gregclacker/Embed2-chicken-coop/kicad/stm test.kicad_pcb

## KiCad design kicad/stm test.kicad_pcb (2026-04-02)

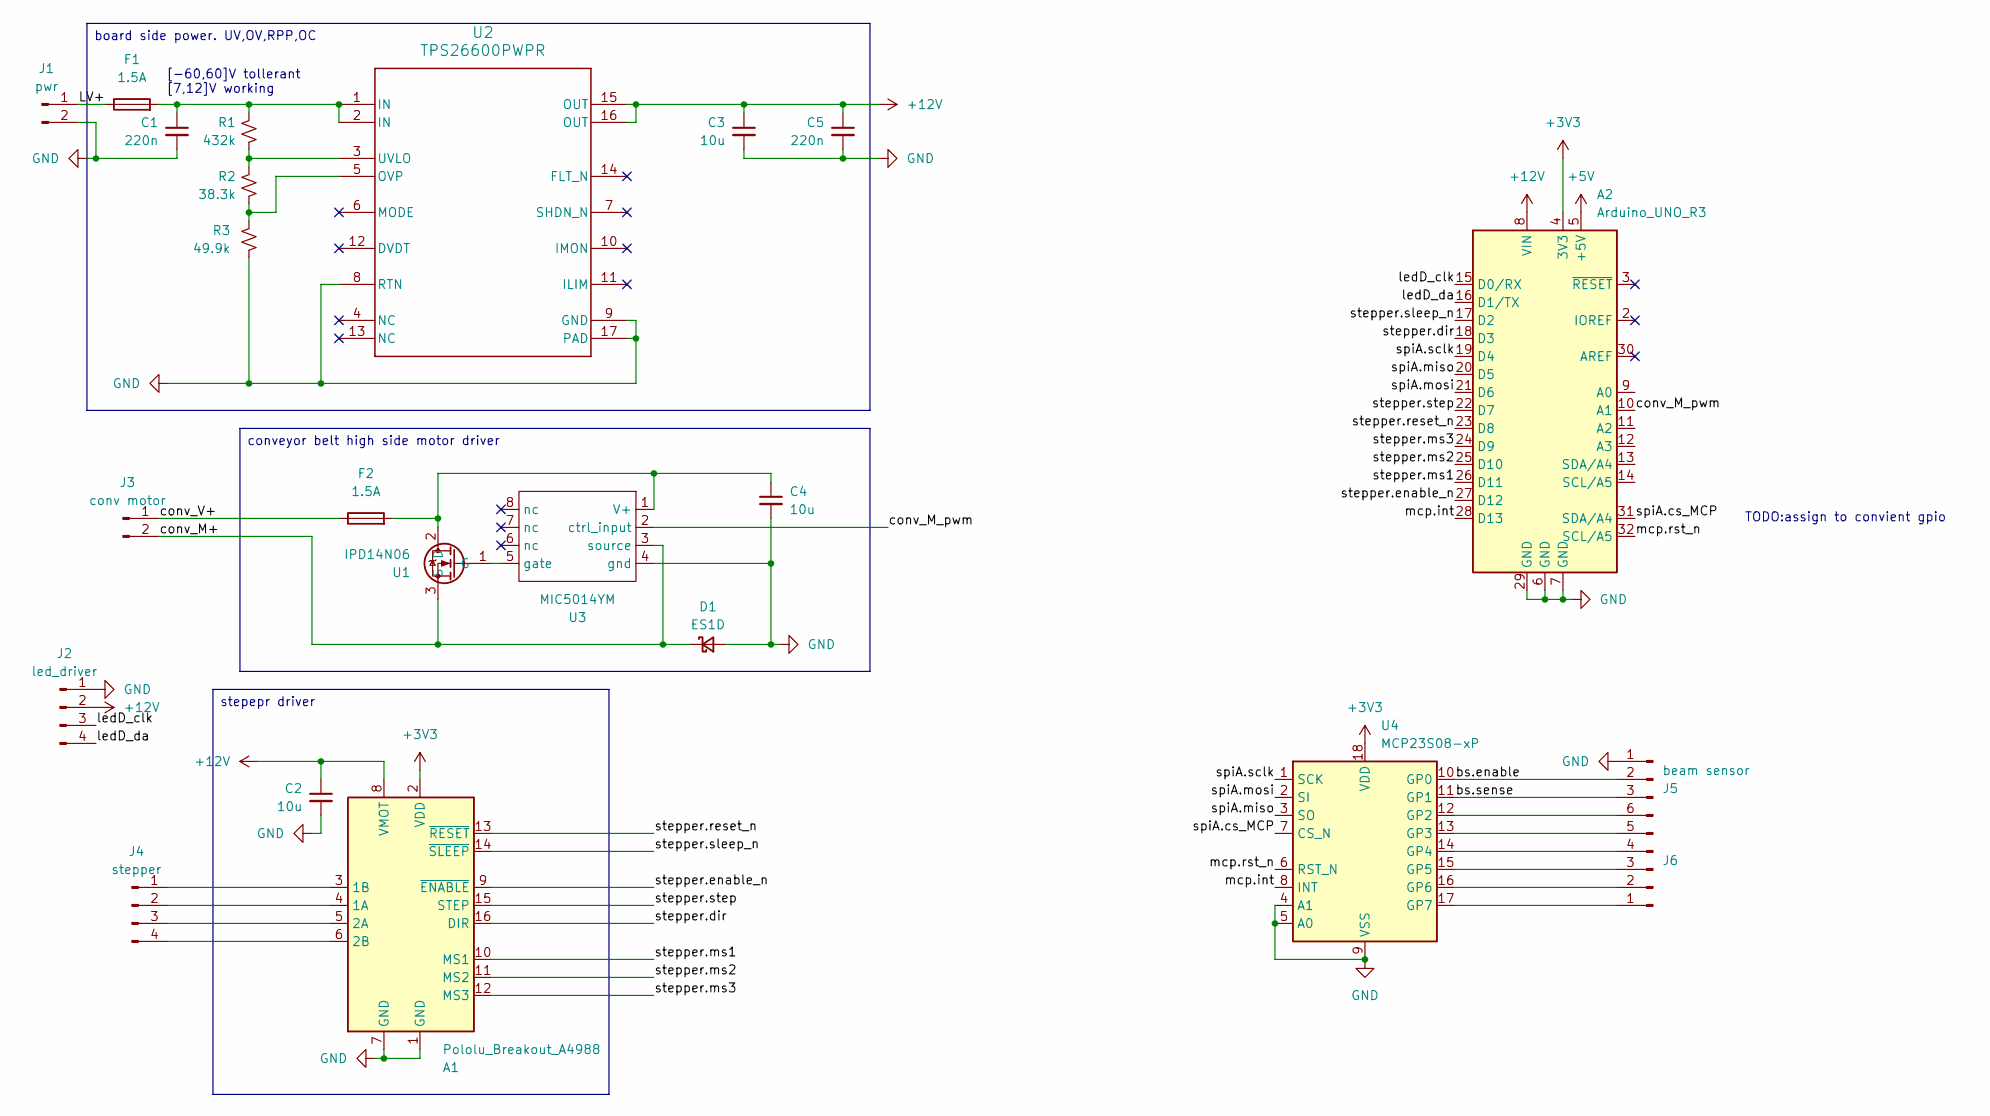
[picture p1: schematic stm test.kicad_sch]

Parts:
A1: Pololu_Breakout_A4988; Pololu_Breakout-16_15.2x20.3mm
A2: Arduino_UNO_R3
C1, C5: 220n; C_0805_2012Metric_Pad1.18x1.45mm_HandSolder
C2, C3, C4: 10u; C_1206_3216Metric_Pad1.33x1.80mm_HandSolder
D1: ES1D; D_SMA
F1, F2: 1.5A; R_Axial_DIN0207_L6.3mm_D2.5mm_P7.62mm_Horizontal
J1: pwr; TerminalBlock_Xinya_XY308-2.54-2P_1x02_P2.54mm_Horizontal
J2: led_driver; TerminalBlock_Xinya_XY308-2.54-4P_1x04_P2.54mm_Horizontal
J3: conv motor; TerminalBlock_Xinya_XY308-2.54-2P_1x02_P2.54mm_Horizontal
J4: stepper; TerminalBlock_Xinya_XY308-2.54-4P_1x04_P2.54mm_Horizontal
J5: beam sensor; TerminalBlock_Xinya_XY308-2.54-3P_1x03_P2.54mm_Horizontal
J6: Conn_01x06_Pin; PinHeader_1x06_P2.54mm_Vertical
R1: 432k; R_1206_3216Metric_Pad1.30x1.75mm_HandSolder
R2: 38.3k; R_0805_2012Metric_Pad1.20x1.40mm_HandSolder
R3: 49.9k; R_0805_2012Metric_Pad1.20x1.40mm_HandSolder
U1: IPD14N06; TO-252-2
U2: TPS26600PWPR; PWP0016H_M
U3: MIC5014YM; SOIC-8_3.9x4.9mm_P1.27mm
U4: MCP23S08-xP; DIP-18_W7.62mm

Connections:
+3V3: A1.2 (VDD), A2.4 (3V3), U4.18 (VDD)
+5V: A2.5 (+5V)
+12V: A1.8 (VMOT), A2.8 (VIN), C2.1, C3.1, C5.1, J2.2, U2.15 (OUT), U2.16 (OUT)
/LV+: F1.1, J1.1
/bs.enable: J5.2, U4.10 (GP0)
/bs.sense: J5.3, U4.11 (GP1)
/conv_M+: D1.1 (K), J3.2, U1.3 (S), U3.3 (source)
/conv_M_pwm: A2.10 (A1), U3.2 (ctrl_input)
/conv_V+: F2.1, J3.1
/ledD_clk: A2.15 (D0/RX), J2.3
/ledD_da: A2.16 (D1/TX), J2.4
/mcp.int: A2.28 (D13), U4.8 (INT)
/mcp.rst_n: A2.32 (SCL/A5), U4.6 (RST_N)
/spiA.cs_MCP: A2.31 (SDA/A4), U4.7 (CS_N)
/spiA.miso: A2.20 (D5), U4.3 (SO)
/spiA.mosi: A2.21 (D6), U4.2 (SI)
/spiA.sclk: A2.19 (D4), U4.1 (SCK)
/stepper.dir: A1.16 (DIR), A2.18 (D3)
/stepper.enable_n: A1.9 (~ENABLE), A2.27 (D12)
/stepper.ms1: A1.10 (MS1), A2.26 (D11)
/stepper.ms2: A1.11 (MS2), A2.25 (D10)
/stepper.ms3: A1.12 (MS3), A2.24 (D9)
/stepper.reset_n: A1.13 (~RESET), A2.23 (D8)
/stepper.sleep_n: A1.14 (~SLEEP), A2.17 (D2)
/stepper.step: A1.15 (STEP), A2.22 (D7)
GND: A1.1 (GND), A1.7 (GND), A2.6 (GND), A2.7 (GND), A2.29 (GND), C1.2, C2.2, C3.2, C4.2, C5.2, D1.2 (A), J1.2, J2.1, J5.1, R3.1, U2.8 (RTN), U2.9 (GND), U2.17 (PAD), U3.4 (gnd), U4.4 (A1), U4.5 (A0), U4.9 (VSS)
unnamed: A1.4 (1A), J4.2
unnamed: A1.3 (1B), J4.1
unnamed: A1.5 (2A), J4.3
unnamed: A1.6 (2B), J4.4
unnamed: C1.1, F1.2, R1.2, U2.1 (IN), U2.2 (IN)
unnamed: J6.1, U4.17 (GP7)
unnamed: J6.2, U4.16 (GP6)
unnamed: J6.3, U4.15 (GP5)
unnamed: J6.4, U4.14 (GP4)
unnamed: J6.5, U4.13 (GP3)
unnamed: J6.6, U4.12 (GP2)
unnamed: C4.1, F2.2, U1.2 (D), U3.1 (V+)
unnamed: U1.1 (G), U3.5 (gate)
unnamed: R2.1, R3.2, U2.5 (OVP)
unnamed: R1.1, R2.2, U2.3 (UVLO)

Notes on the sheet:
[-60,60]V tollerant [7,12]V working
TODO:assign to convient gpio
stepepr driver
conveyor belt high side motor driver
board side power. UV,OV,RPP,OC

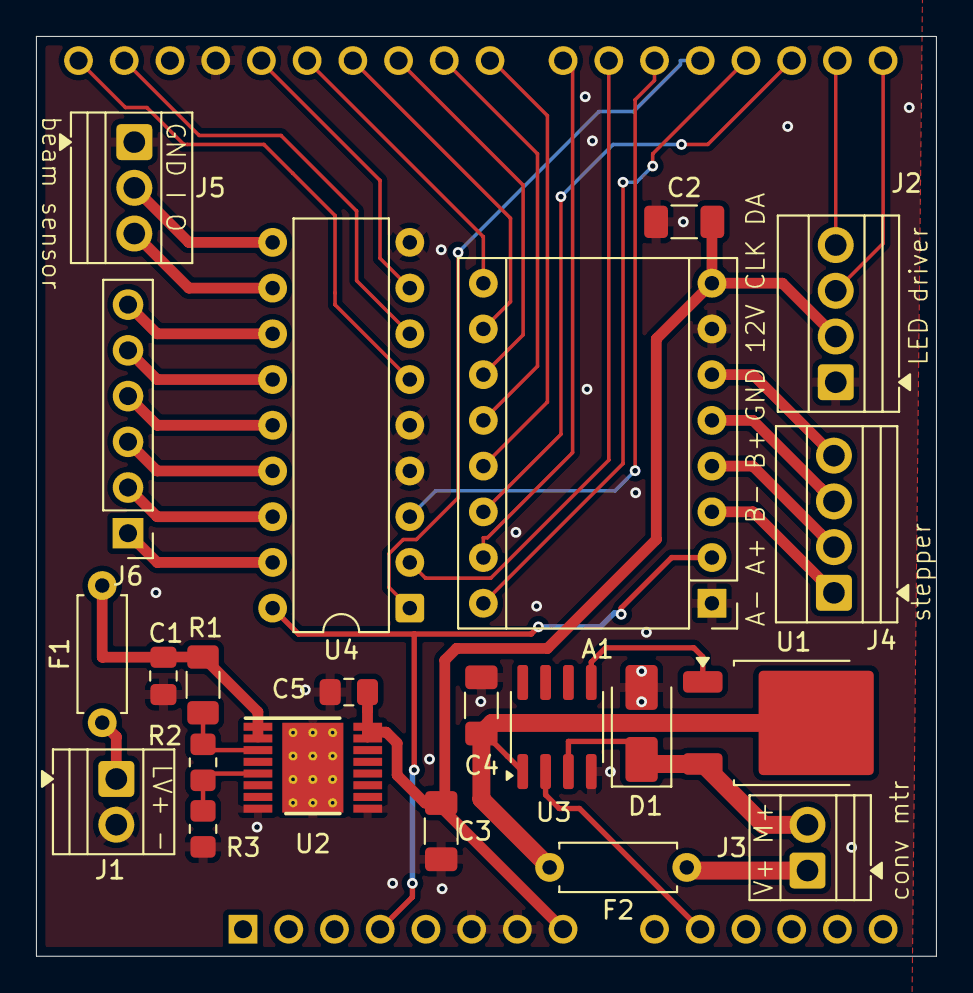
[picture p2: board stm test.kicad_pcb from above]

Board: 2 copper layers, 50.0 x 51.1 mm, 23 parts (1 on the bottom side), 40 nets.
