gregclacker/Embed2-chicken-coop/(commit log)

2026-03-30 corrected spi wiring error
    [stm test.kicad_sch]
2026-04-01 beam sensor and conveyor belt code
2026-04-02 i fugged up
    [stm test.kicad_pcb, stm test.kicad_sch]
2026-04-08 test pin
    [stm test.kicad_sch]
2026-04-13 corrected stepper pins and led driver pins
    [main.c]
2026-04-17 added hall effect sensors
2026-04-20 led test
